kuanyusu/NCTU-Cheetah/mechanism/README.md

# Mechanism

Here are some mechanisms(.stl) for the NCTU-Cheetah. 
Besides, the legs of this cheetah are bilateral symmetry, therefore I only provide one side of the legs.
