kuanyusu/NCTU-Cheetah/fig.2.jpg

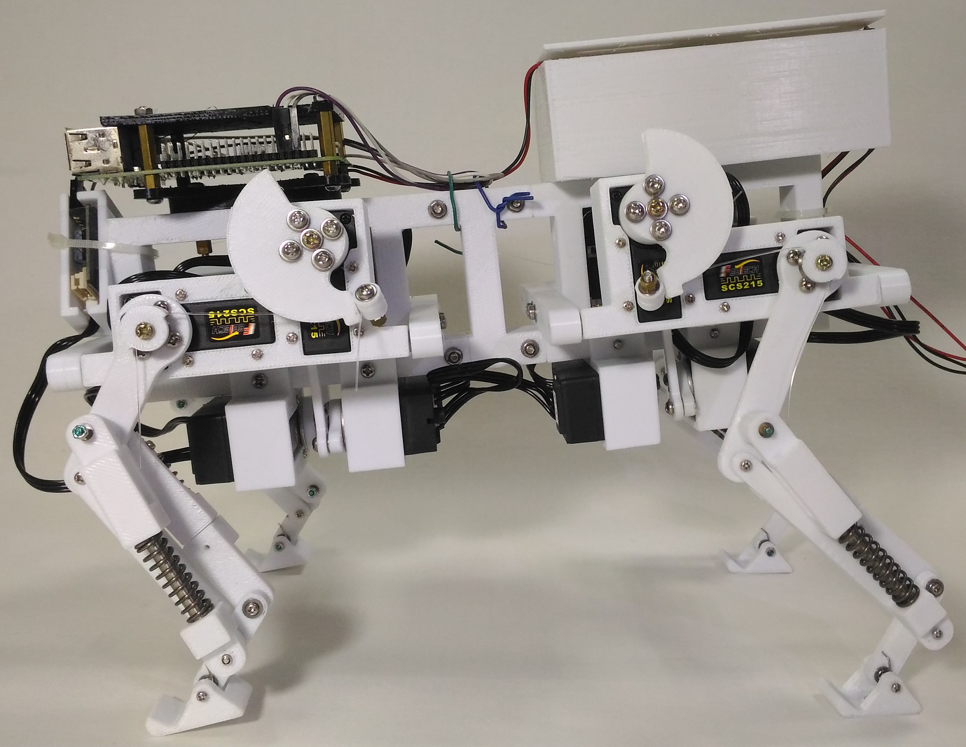
fig.2.jpg
