kuanyusu/NCTU-Cheetah/fig.4.jpg

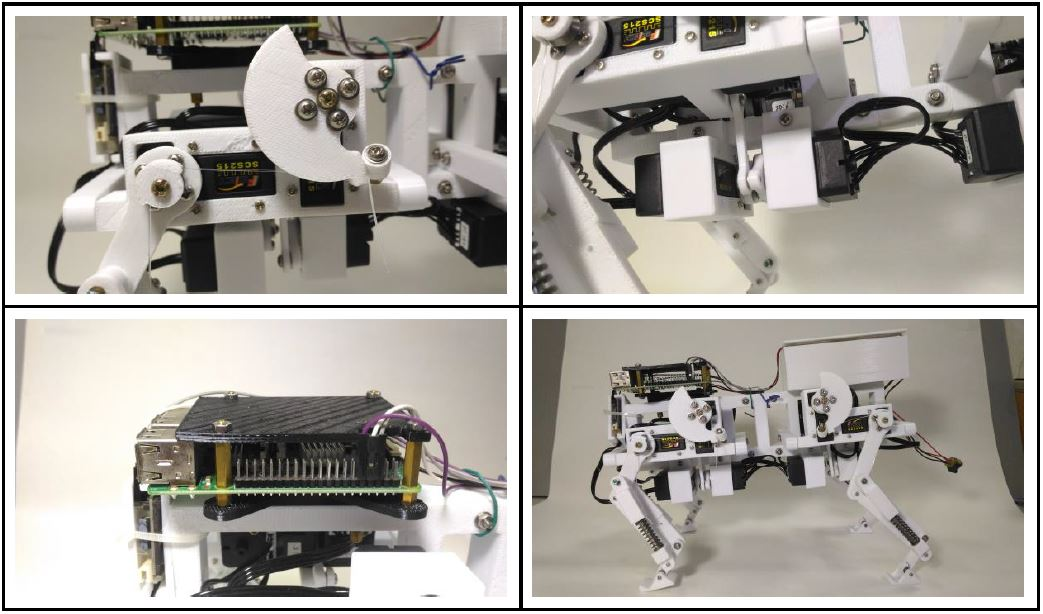
fig.4.jpg
