kuanyusu/NCTU-Cheetah/mechanism/turning_mechanism.stl

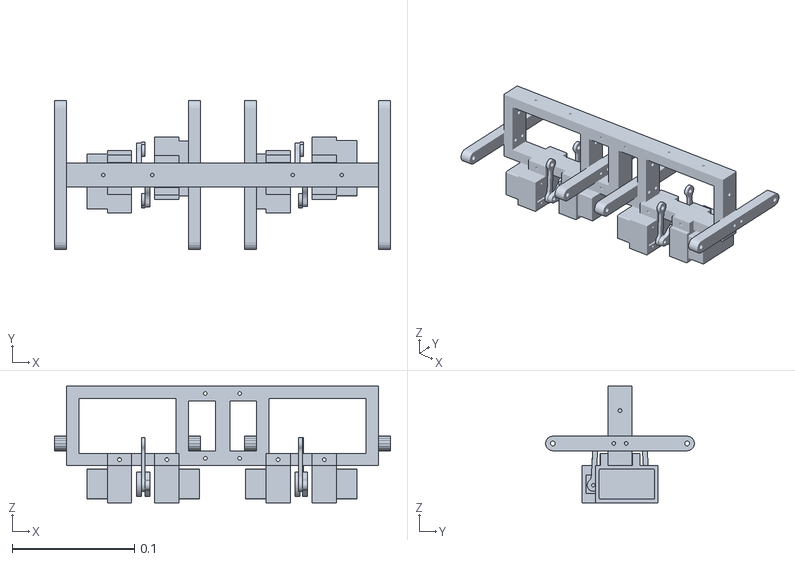
[picture p5: CAD file, 2019-09-15]
mechanism/turning_mechanism.stl
0.275 x 0.122 x 0.0955
