kuanyusu/NCTU-Cheetah/mechanism/left_foreleg_l3.stl

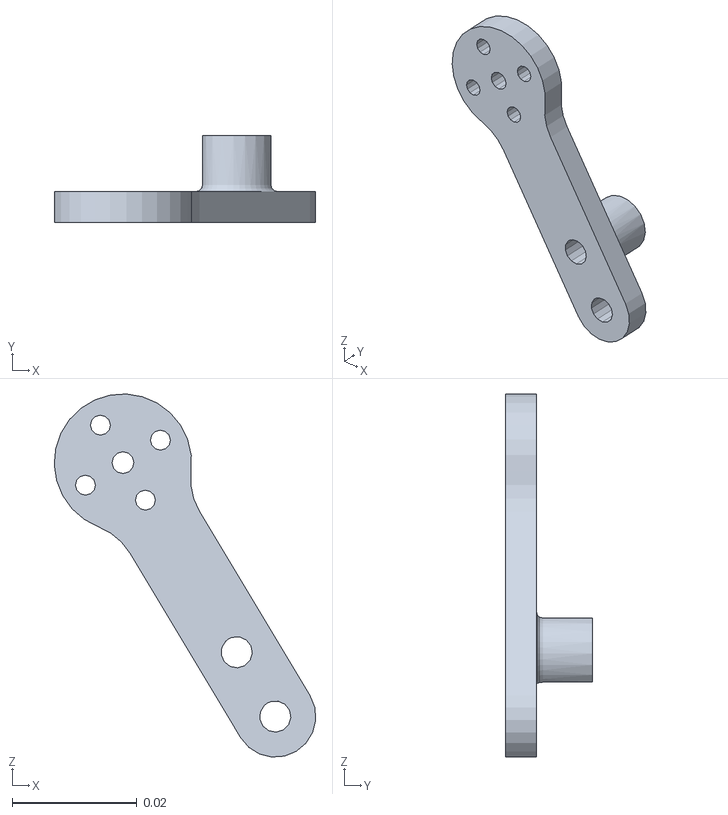
[picture p6: CAD file, 2019-09-15]
mechanism/left_foreleg_l3.stl
0.0419 x 0.014 x 0.0581
