kuanyusu/NCTU-Cheetah/mechanism/left_foreleg.stl

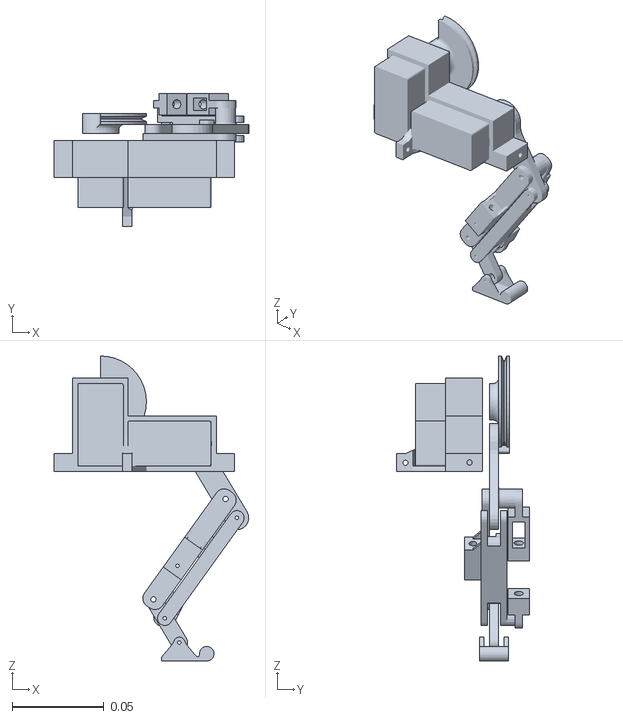
[picture p7: CAD file, 2019-09-15]
mechanism/left_foreleg.stl
0.106 x 0.0729 x 0.167
