kuanyusu/NCTU-Cheetah/mechanism/left_foreleg_spring_p_up.stl

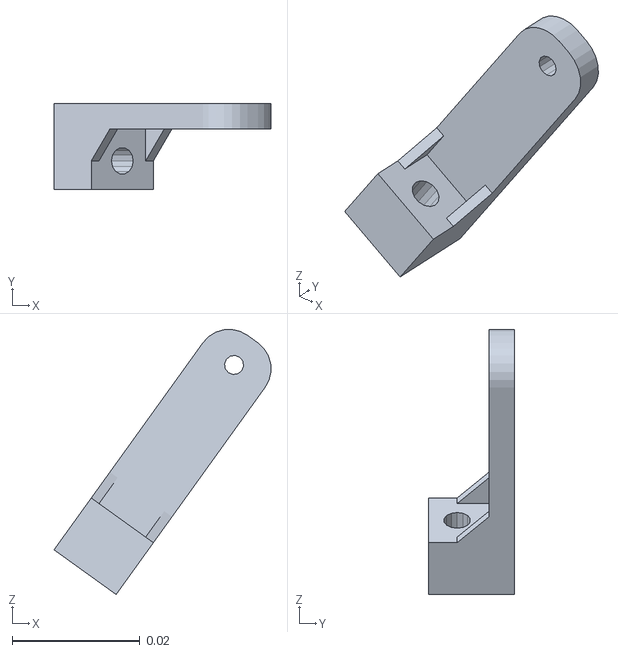
[picture p8: CAD file, 2019-09-15]
mechanism/left_foreleg_spring_p_up.stl
0.034 x 0.0135 x 0.0415
