kuanyusu/NCTU-Cheetah/mechanism/left_foreleg_l1.stl

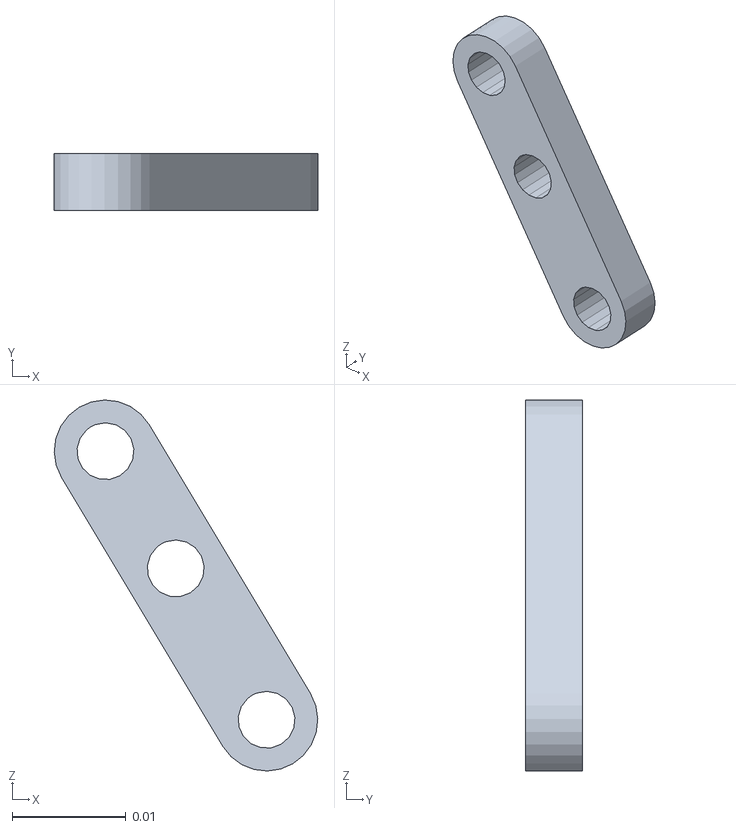
[picture p9: CAD file, 2019-09-15]
mechanism/left_foreleg_l1.stl
0.0231 x 0.005 x 0.0326
