kuanyusu/NCTU-Cheetah/mechanism/left_foreleg_l2.stl

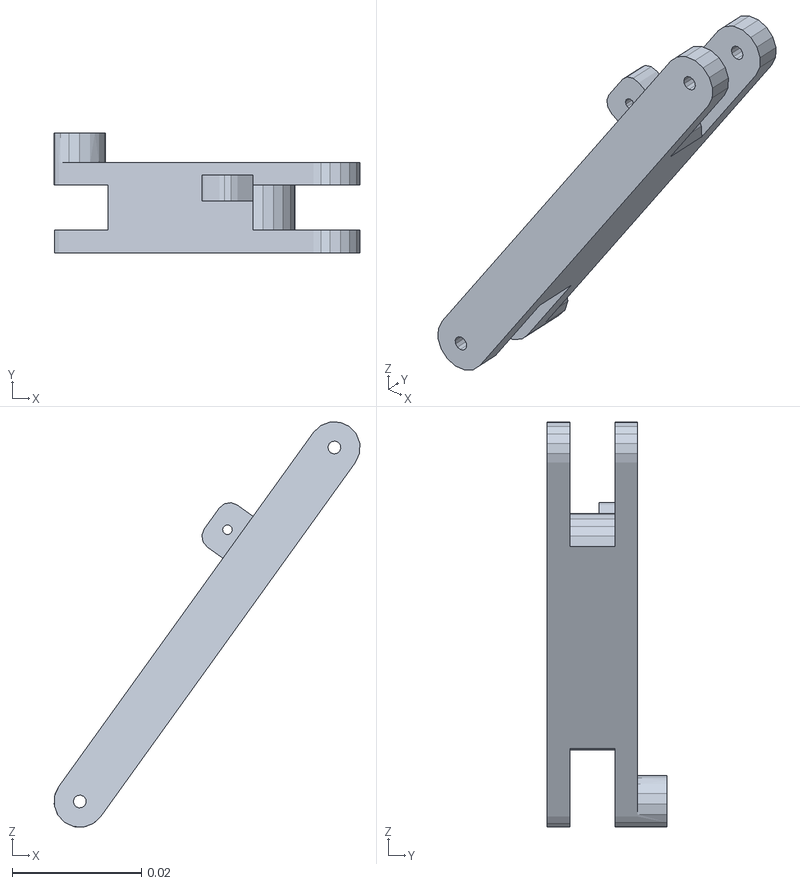
[picture p10: CAD file, 2019-09-15]
mechanism/left_foreleg_l2.stl
0.0473 x 0.0185 x 0.0627
