kuanyusu/NCTU-Cheetah/mechanism/base.stl

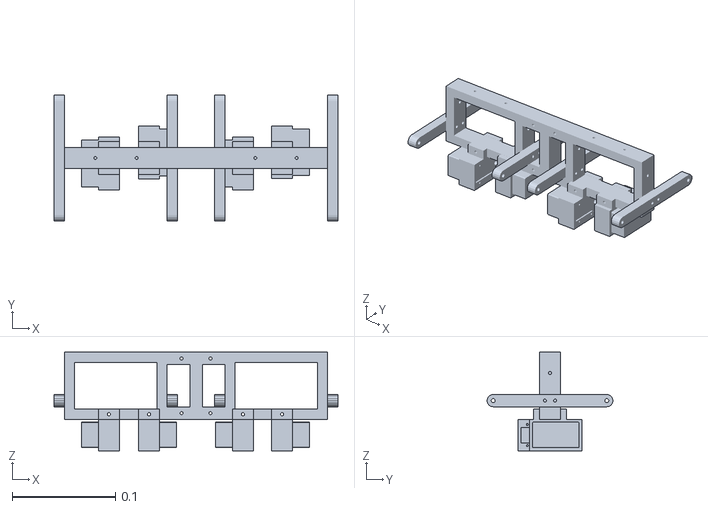
[picture p11: CAD file, 2019-09-15]
mechanism/base.stl
0.275 x 0.122 x 0.0955
