kuanyusu/NCTU-Cheetah/mechanism/left_foreleg_frame.stl

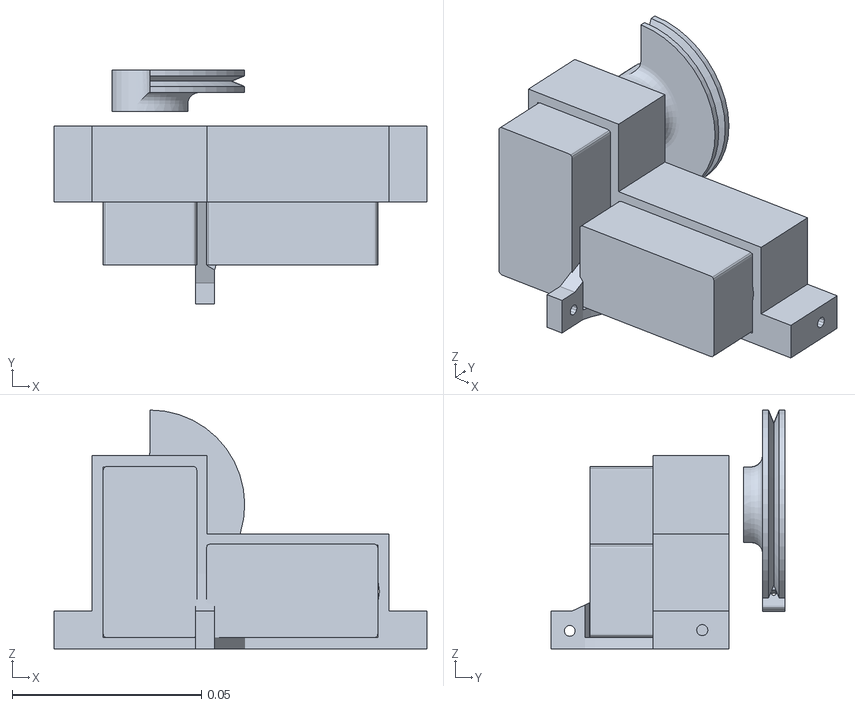
[picture p12: CAD file, 2019-09-15]
mechanism/left_foreleg_frame.stl
0.0985 x 0.0619 x 0.0631
