kuanyusu/NCTU-Cheetah/mechanism/left_hindleg.stl

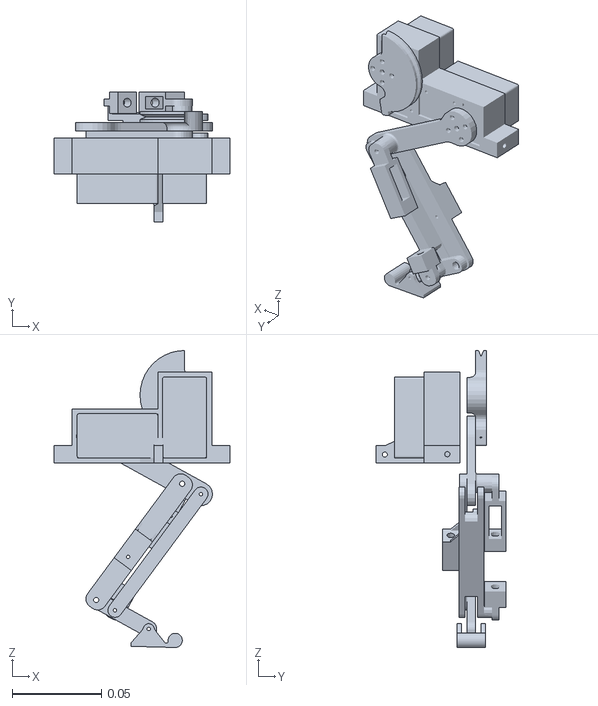
[picture p13: CAD file, 2019-09-15]
mechanism/left_hindleg.stl
0.0985 x 0.0729 x 0.166
