kuanyusu/NCTU-Cheetah/mechanism/left_foreleg_spring_d_down.stl

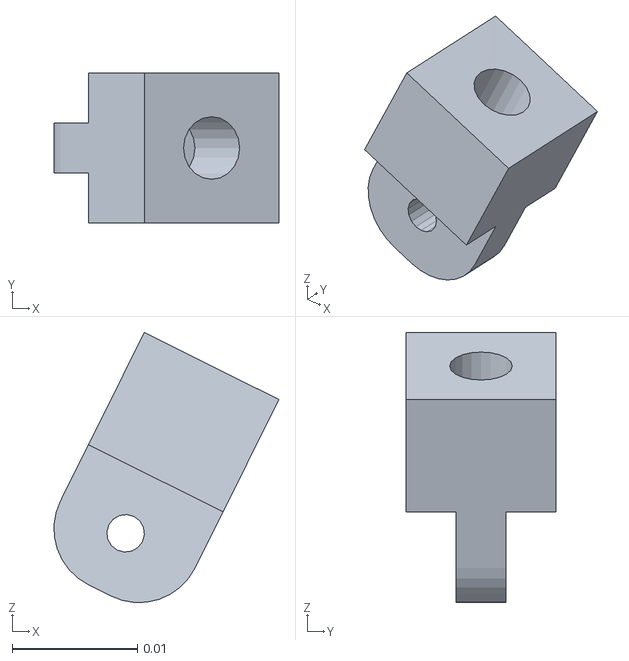
[picture p14: CAD file, 2019-09-15]
mechanism/left_foreleg_spring_d_down.stl
0.0179 x 0.012 x 0.0215
