kuanyusu/NCTU-Cheetah/mechanism/left_foreleg_foot.stl

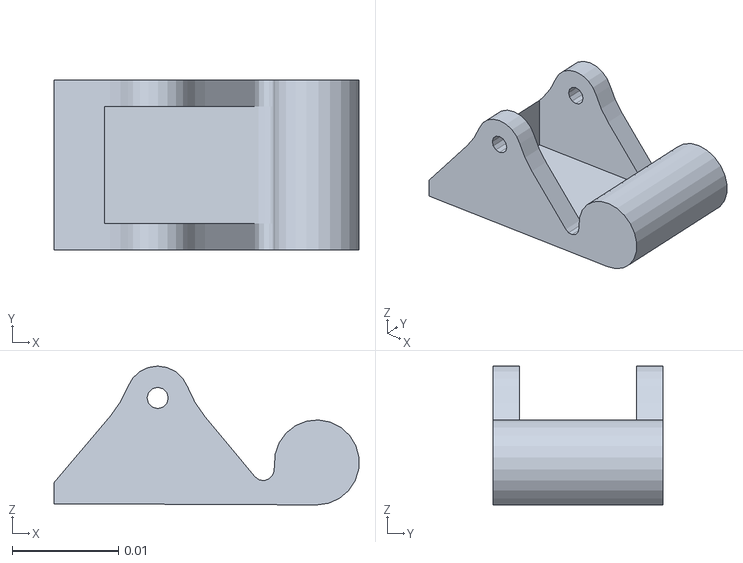
[picture p15: CAD file, 2019-09-15]
mechanism/left_foreleg_foot.stl
0.0287 x 0.016 x 0.0131
