kuanyusu/NCTU-Cheetah/mechanism/left_foreleg_spring_d_up.stl

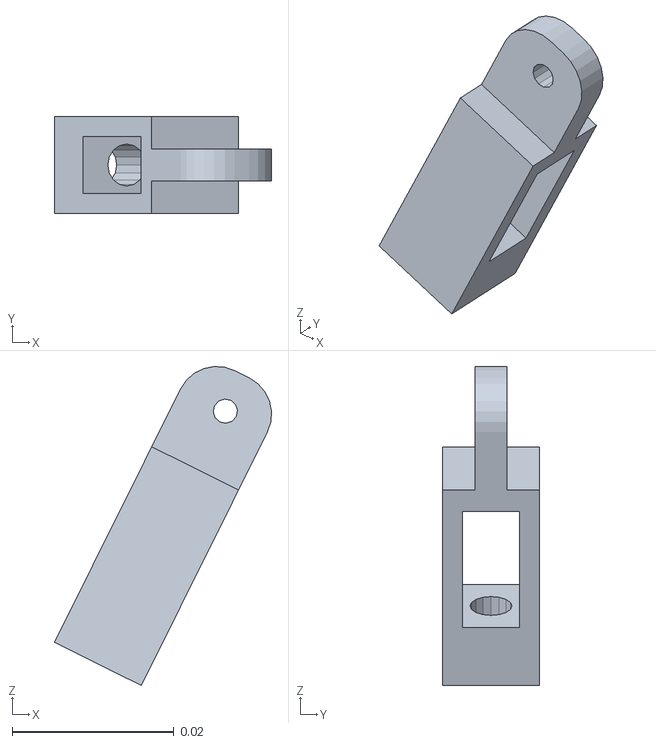
[picture p16: CAD file, 2019-09-15]
mechanism/left_foreleg_spring_d_up.stl
0.0268 x 0.012 x 0.0394
