kuanyusu/NCTU-Cheetah/mechanism/left_foreleg_spring_p_down.stl

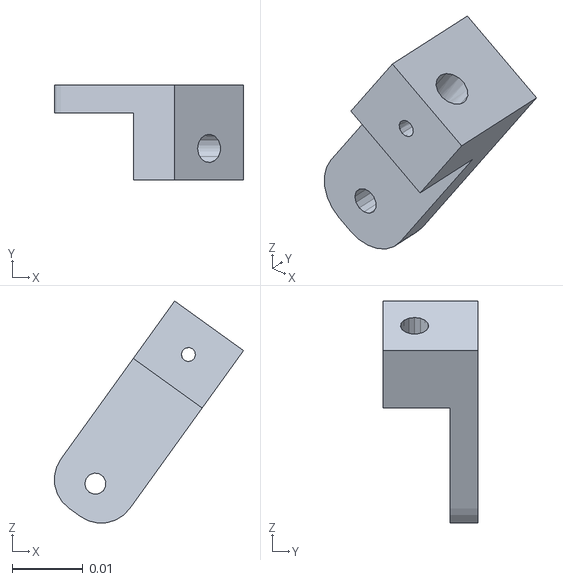
[picture p17: CAD file, 2019-09-15]
mechanism/left_foreleg_spring_p_down.stl
0.0267 x 0.0135 x 0.0314
